romkey/pdxhackerspace-pendant-light-diffuser/images/e27_plug_section.png

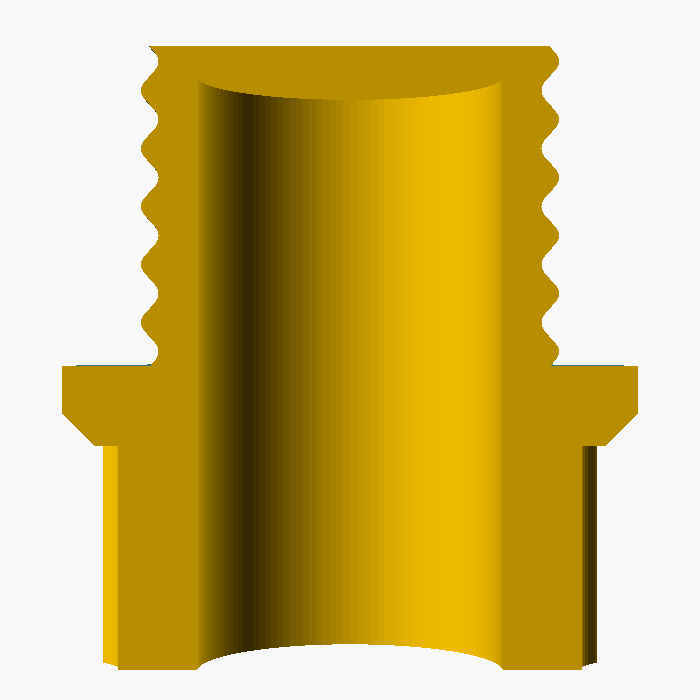
images/e27_plug_section.png
