romkey/pdxhackerspace-pendant-light-diffuser/stl/diffuser_disc.stl

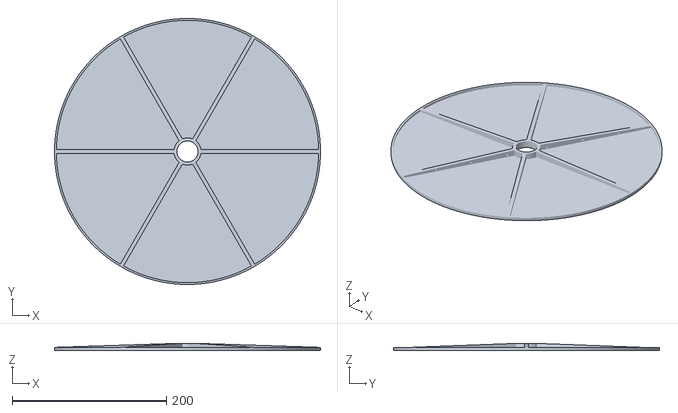
[picture p11: CAD file, 2026-11-08]
stl/diffuser_disc.stl
345.2 x 345.2 x 9.20
