romkey/pdxhackerspace-pendant-light-diffuser/stl/diffuser_hex_segment.stl

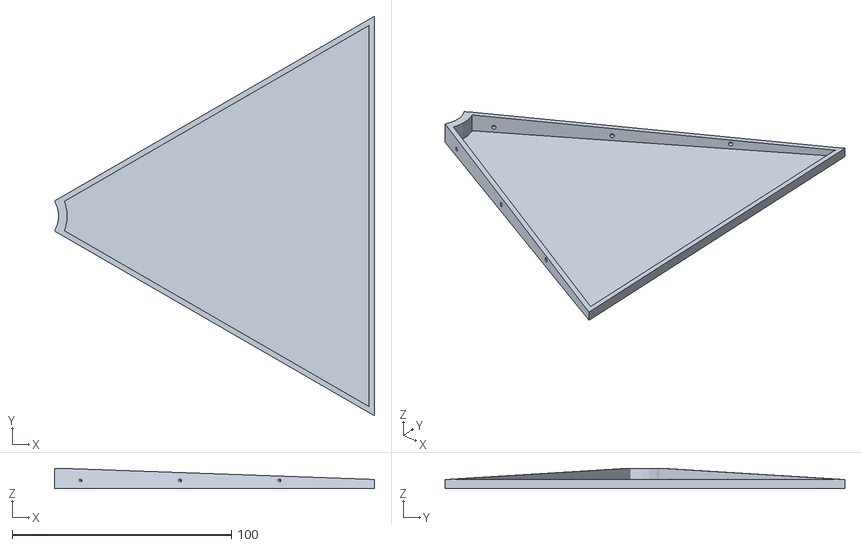
[picture p12: CAD file, 2026-11-08]
stl/diffuser_hex_segment.stl
146.0 x 182.3 x 9.20
