romkey/pdxhackerspace-pendant-light-diffuser/stl/diffuser_hex.stl

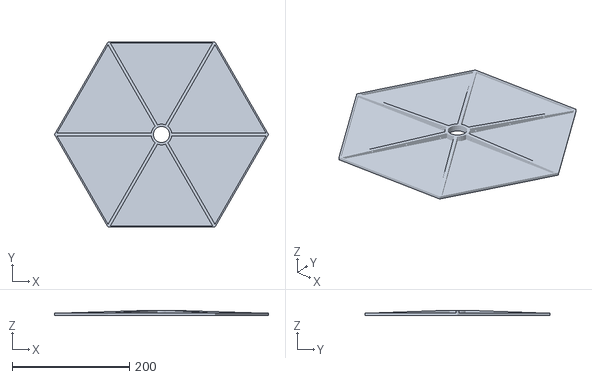
[picture p13: CAD file, 2026-11-08]
stl/diffuser_hex.stl
364.6 x 315.8 x 9.20
