romkey/pdxhackerspace-pendant-light-diffuser/stl/e27_plug.stl

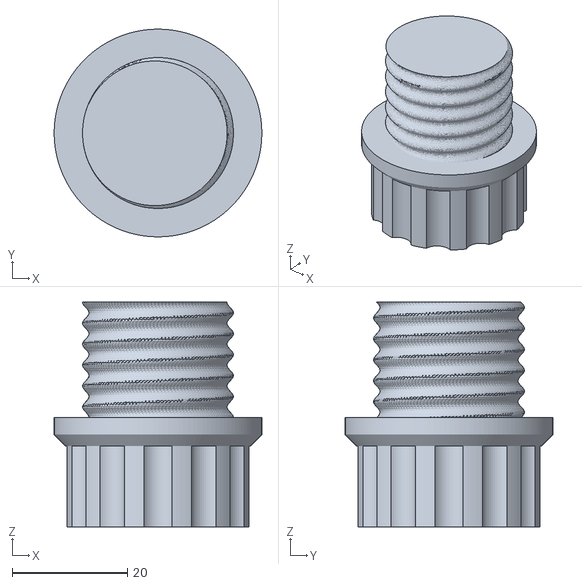
[picture p14: CAD file, 2026-11-08]
stl/e27_plug.stl
36.0 x 36.0 x 39.0
