romkey/pdxhackerspace-pendant-light-diffuser/stl/diffuser_segment.stl

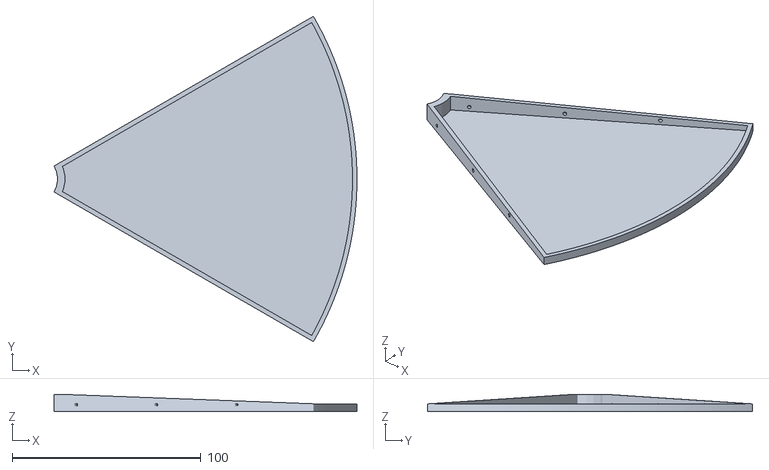
[picture p15: CAD file, 2026-11-08]
stl/diffuser_segment.stl
160.7 x 172.6 x 9.20
