romkey/pdxhackerspace-pendant-light-diffuser/src/diffuser_disc.scad

// Round diffuser disc, in one piece. For printers big enough to print it
// whole; otherwise print diffuser_segment.scad. Geometry is in diffuser_lib.scad.

use <diffuser_lib.scad>

diffuser("circle");
