romkey/pdxhackerspace-pendant-light-diffuser/src/diffuser_hex_segment.scad

// One wedge of the hexagonal diffuser: an equilateral triangle. Print
// `segments` copies (6 by default) and join them along the ribs with
// filament pins and glue.

use <diffuser_lib.scad>

printable_wedge("hex");
