romkey/pdxhackerspace-pendant-light-diffuser/(list of files, cad)

Other CAD files:
dxf/diffuser_hex_laser.dxf
src/diffuser_hex.scad
src/diffuser_segment.scad
